connorzheng97/xv5080-psu/xv5080_psu/production/bom.csv

Designator | Footprint | Quantity | Value | LCSC Part #
C1, C2, C3, C4 | 1206 | 4 | 25V/22uF/X5R
C10, C5, C6, C7, C8, C9 | 0805 | 6 | 100nF
C11, C12 | 1206 | 2 | 10V/47uF/X5R
C13 | CP_Radial_D8.0mm_P3.50mm | 1 | 10V/470uF
C14 | CP_Radial_D6.3mm_P2.50mm | 1 | 10V/220uF
C15, C16, C17, C18 | CP_Radial_D6.3mm_P2.50mm | 4 | 25V/220uF
J1 | JST_PH_B12B-PH-K_1x12_P2.00mm_Vertical | 1 | JST_PH_B12B-PH-K
J2 | JST_PH_B8B-PH-K_1x08_P2.00mm_Vertical | 1 | JST_PH_B8B-PH-K
J3 | CONN_ScrewTerminal_KF-7.62-6P | 1 | ScrewTerminal_7.62_4p
R1 | 0603 | 1 | 360R
R2 | 0603 | 1 | 3.6R
R3 | 0603 | 1 | 120R
R4 | 0603 | 1 | 13K
R5 | 0603 | 1 | 1.3K
R6 | 0603 | 1 | 1.8K
R7 | 0603 | 1 | 5.6K
R8 | 0603 | 1 | 130K
R9 | 0603 | 1 | 12K
U1 | TO-263-5_TabPin3 | 1 | MIC29502WU
U2 | TO-263-5_TabPin3 | 1 | LT1963EQ
U3 | TO-263-5_TabPin3 | 1 | LT3015Q
