connorzheng97/xv5080-psu/chassis/xv5080_psu_chassis.STEP

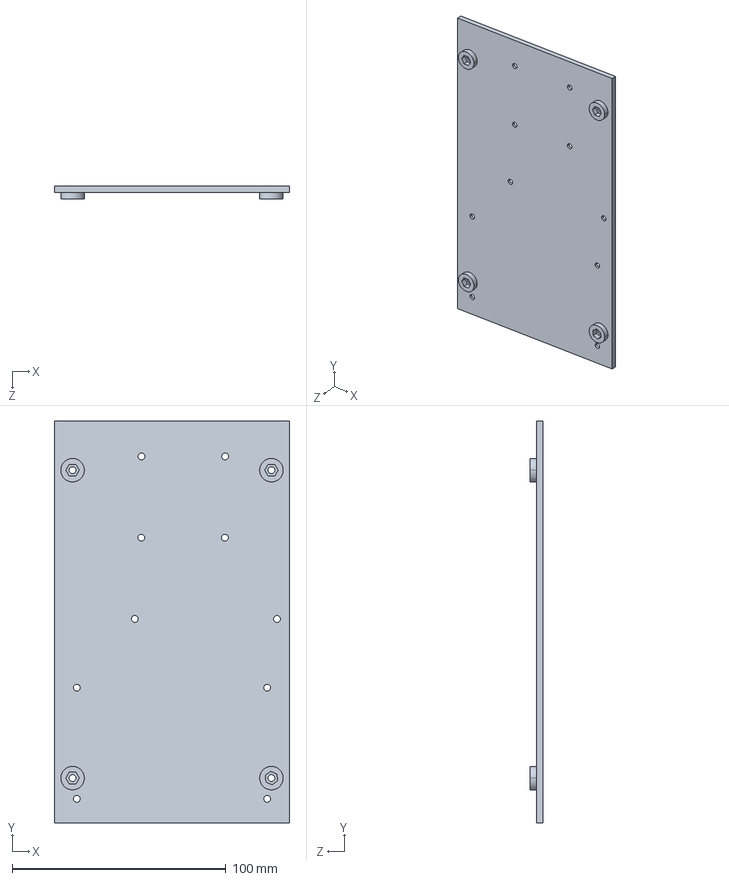
[picture p9: CAD file, 2026-10-16]
chassis/xv5080_psu_chassis.STEP
110.0 x 188.0 x 6.00 mm
