connorzheng97/xv5080-psu/(list of files, cad)

Other CAD files:
chassis/xv5080_psu_chassis.SLDPRT
chassis/xv5080_psu_chassis.STL
