connorzheng97/xv5080-psu/xv5080_psu/xv5080_psu_schematic.pdf

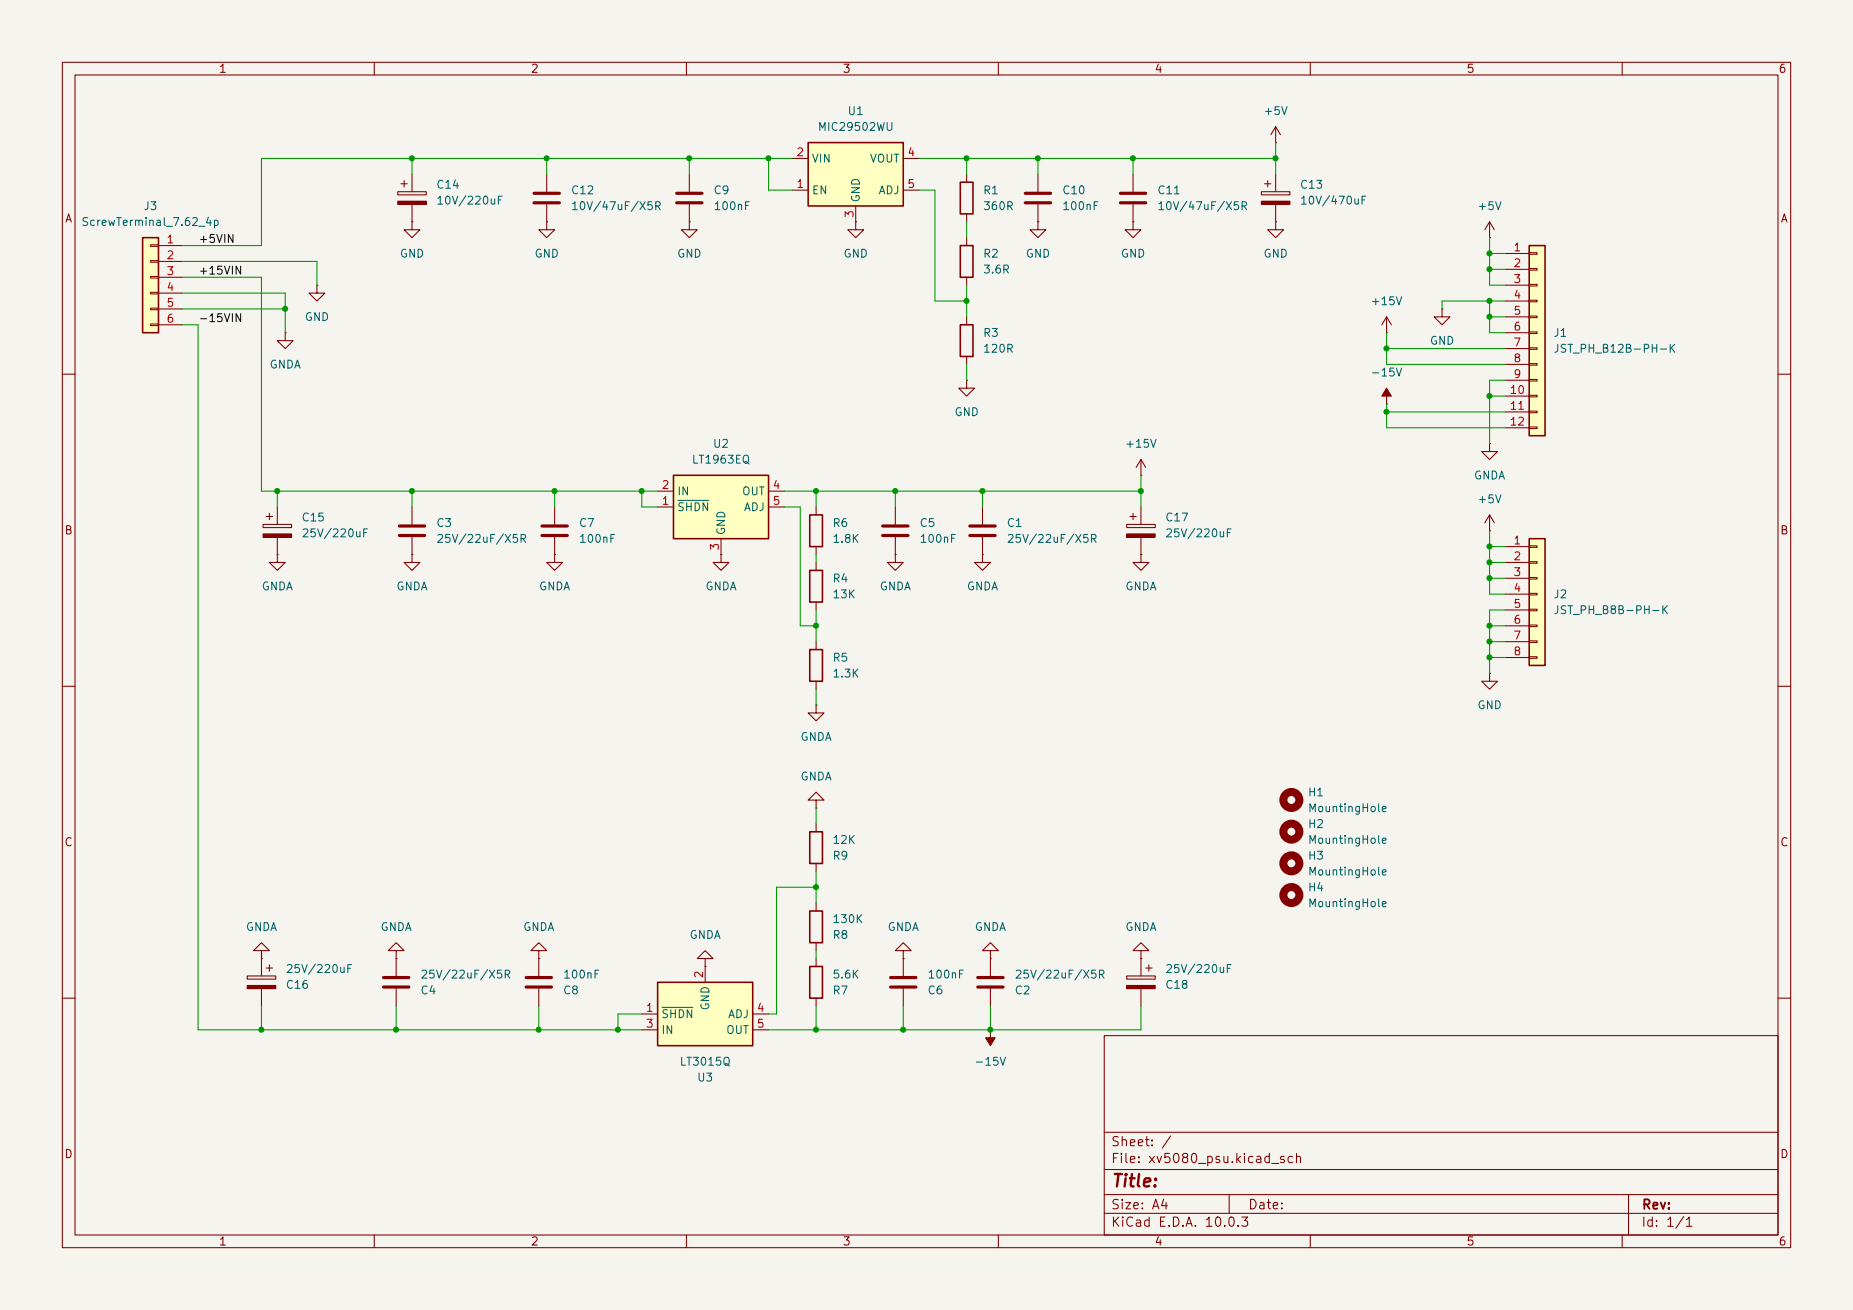
[picture p10: page 1]
