connorzheng97/xv5080-psu/xv5080_psu/xv5080_psu.kicad_pcb

## KiCad design xv5080_psu/xv5080_psu.kicad_pcb (2026-10-16)

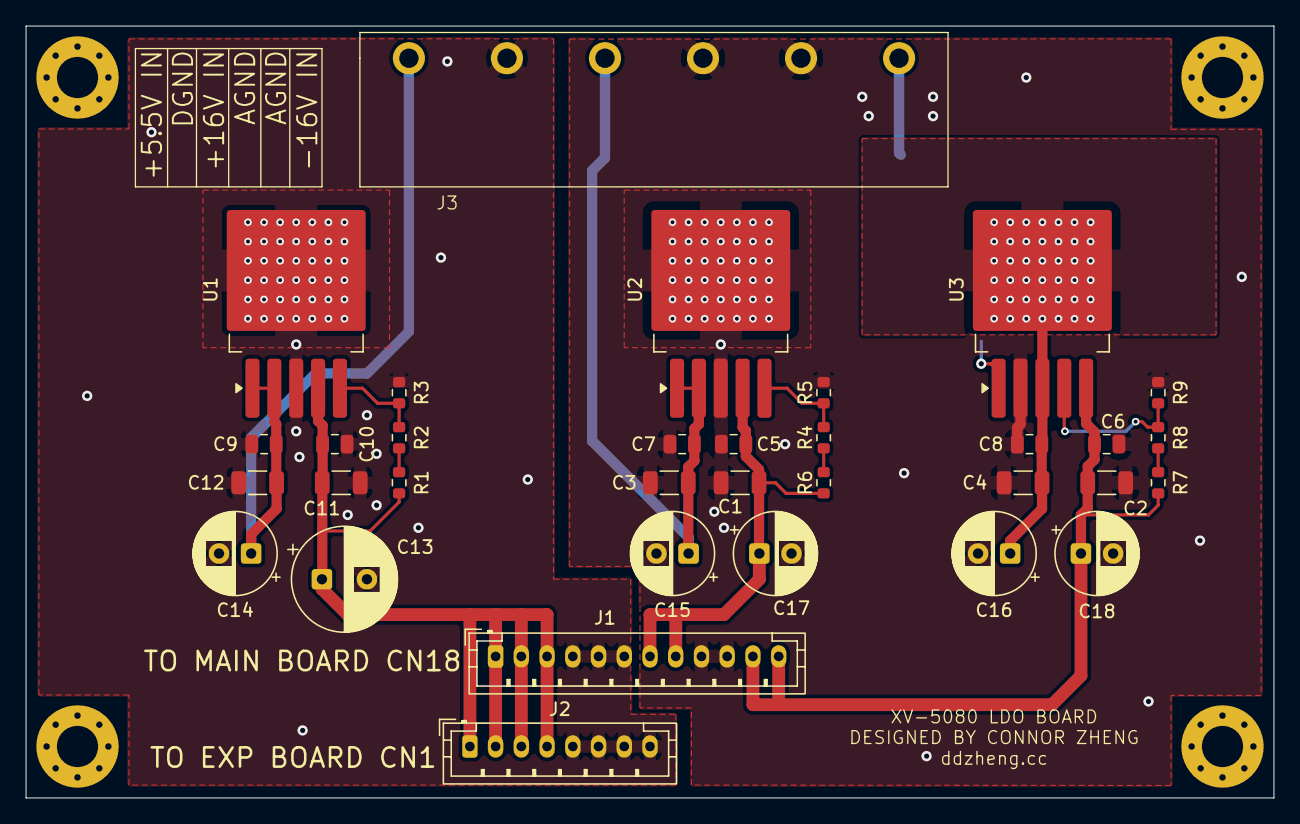
[picture p11: board xv5080_psu.kicad_pcb from above]

Board: 2 copper layers, 97.0 x 60.0 mm, 37 parts (0 on the bottom side), 14 nets.

Parts:
C1, C2, C3, C4: 25V/22uF/X5R; C_1206_3216Metric
C5, C6, C7, C8, C9, C10: 100nF; C_0805_2012Metric
C11, C12: 10V/47uF/X5R; C_1206_3216Metric
C13: 10V/470uF; CP_Radial_D8.0mm_P3.50mm
C14: 10V/220uF; CP_Radial_D6.3mm_P2.50mm
C15, C16, C17, C18: 25V/220uF; CP_Radial_D6.3mm_P2.50mm
H1, H2, H3, H4: MountingHole; MountingHole_3.2mm_M3_Pad_Via
J1: JST_PH_B12B-PH-K; JST_PH_B12B-PH-K_1x12_P2.00mm_Vertical
J2: JST_PH_B8B-PH-K; JST_PH_B8B-PH-K_1x08_P2.00mm_Vertical
J3: ScrewTerminal_7.62_4p; CONN_ScrewTerminal_KF-7.62-6P
R1: 360R; R_0603_1608Metric
R2: 3.6R; R_0603_1608Metric
R3: 120R; R_0603_1608Metric
R4: 13K; R_0603_1608Metric
R5: 1.3K; R_0603_1608Metric
R6: 1.8K; R_0603_1608Metric
R7: 0R; R_0603_1608Metric
R8: 140K; R_0603_1608Metric
R9: 12.4K; R_0603_1608Metric
U1: MIC29502WU; TO-263-5_TabPin3
U2: LT1963EQ; TO-263-5_TabPin3
U3: LT3015Q; TO-263-5_TabPin3

Connections:
+5V: C10.1, C11.1, C13.1, J1.1, J1.2, J1.3, J2.1, J2.2, J2.3, J2.4, R1.1, U1.4 (VOUT)
+15V: C1.1, C5.1, C17.1, J1.7, J1.8, R6.1, U2.4 (OUT)
-15V: C2.1, C6.1, C18.1, J1.11, J1.12, R7.1, U3.5 (OUT)
/+5VIN: C9.1, C12.1, C14.1, J3.1, U1.1 (EN), U1.2 (VIN)
/+15VIN: C3.1, C7.1, C15.1, J3.3, U2.1 (~SHDN), U2.2 (IN)
/-15VIN: C4.1, C8.1, C16.1, J3.6, U3.1 (~SHDN), U3.3 (IN)
GND: C9.2, C10.2, C11.2, C12.2, C13.2, C14.2, J1.4, J1.5, J1.6, J2.5, J2.6, J2.7, J2.8, J3.2, R3.2, U1.3 (GND)
GNDA: C1.2, C2.2, C3.2, C4.2, C5.2, C6.2, C7.2, C8.2, C15.2, C16.2, C17.2, C18.2, J1.9, J1.10, J3.4, J3.5, R5.2, R9.2, U2.3 (GND), U3.2 (GND)
unnamed: R1.2, R2.1
unnamed: R4.1, R6.2
unnamed: R7.2, R8.1
unnamed: R2.2, R3.1, U1.5 (ADJ)
unnamed: R4.2, R5.1, U2.5 (ADJ)
unnamed: R8.2, R9.1, U3.4 (ADJ)
